thijses/longboard_2024/extra docs/mathcad file contents.png

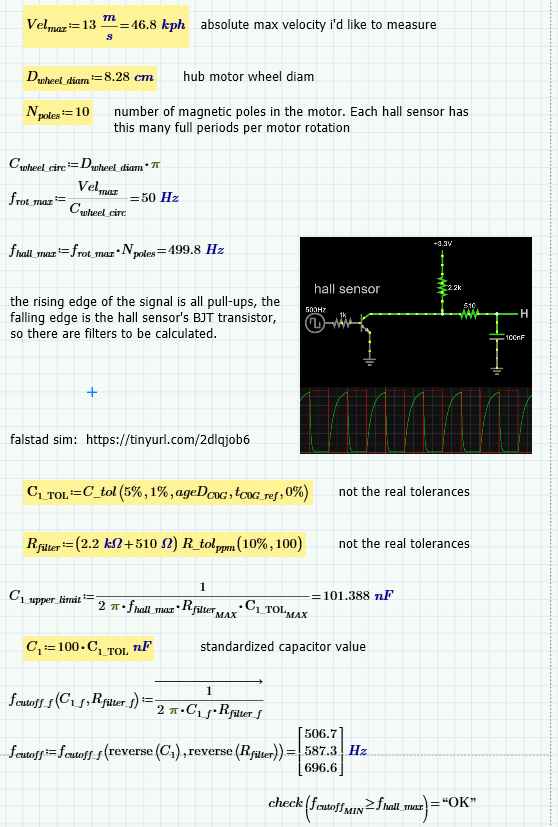
extra docs/mathcad file contents.png
