thijses/longboard_2024/extra docs/pogo board legend.png

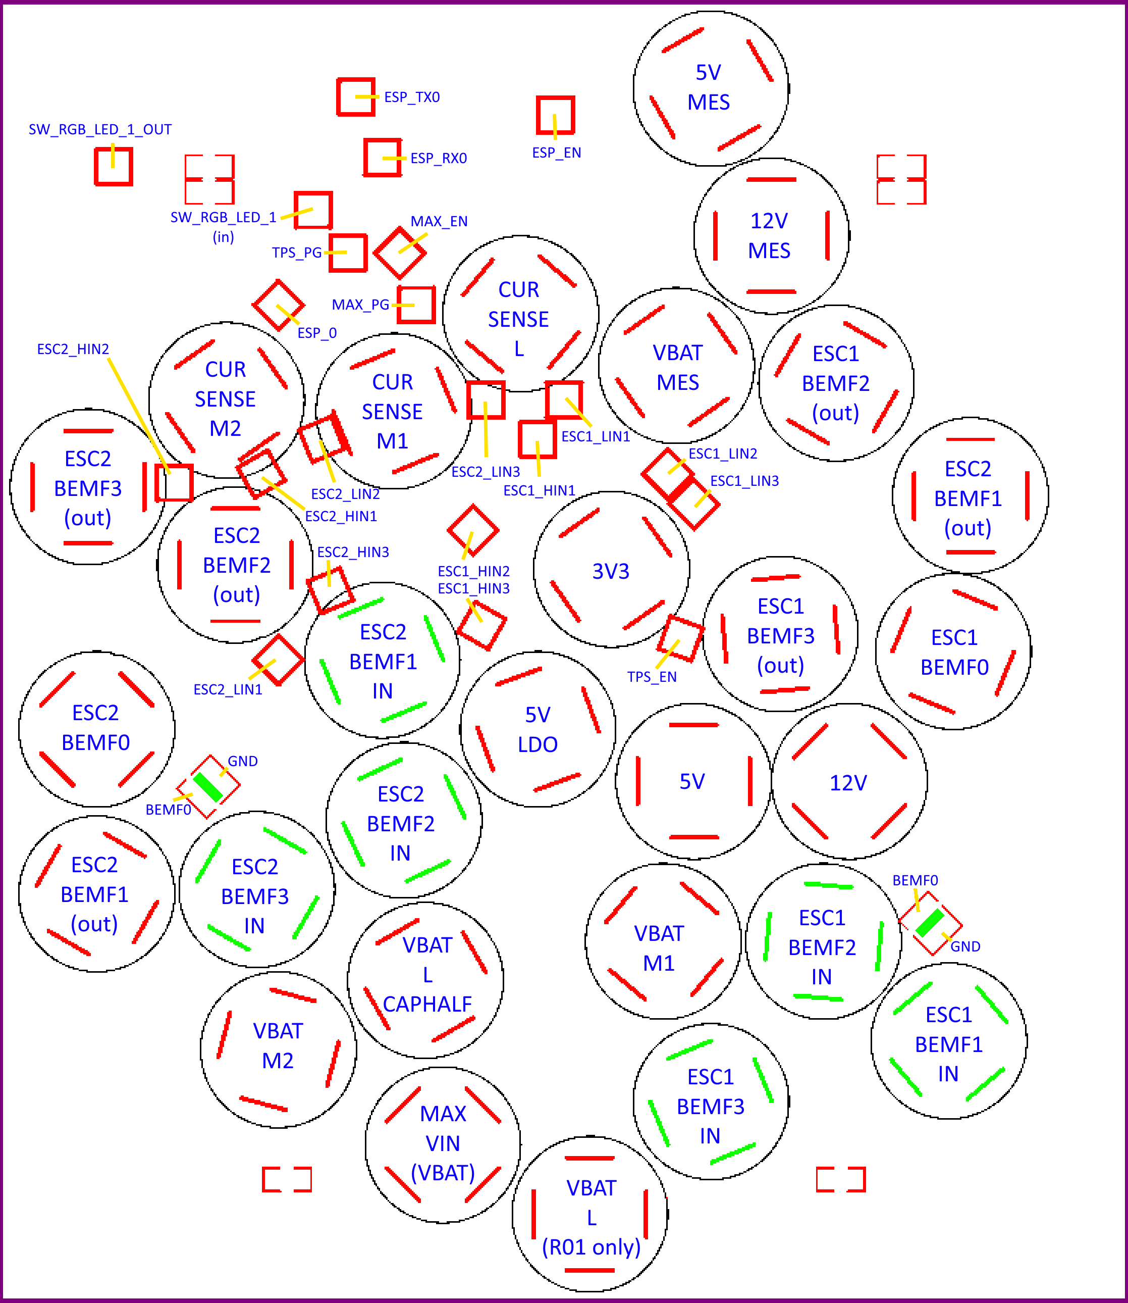
extra docs/pogo board legend.png
