thijses/longboard_2024/extra docs/scope screenshots/extra noise (unidentified).png

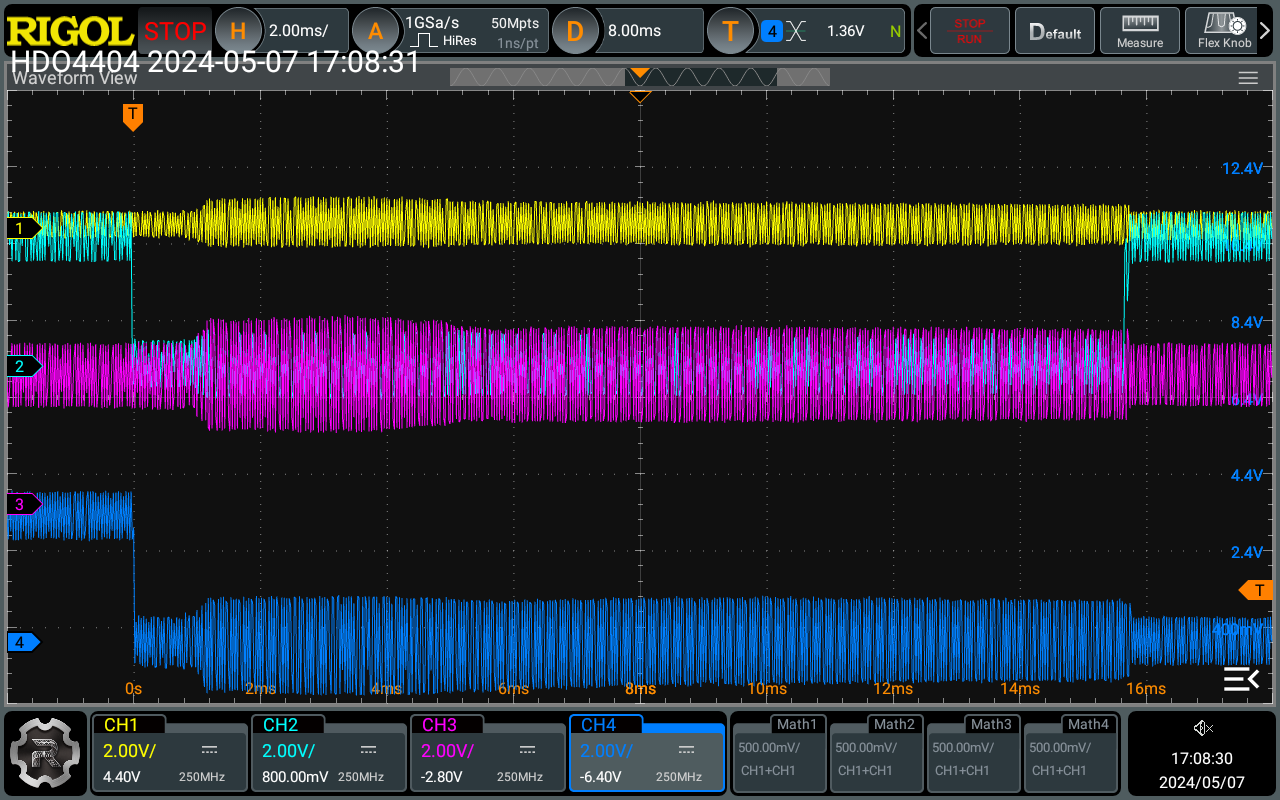
extra docs/scope screenshots/extra noise (unidentified).png
