thijses/longboard_2024/extra docs/scope screenshots/missed B (ch2) 4ms earlier, error comes on next interrupt.png

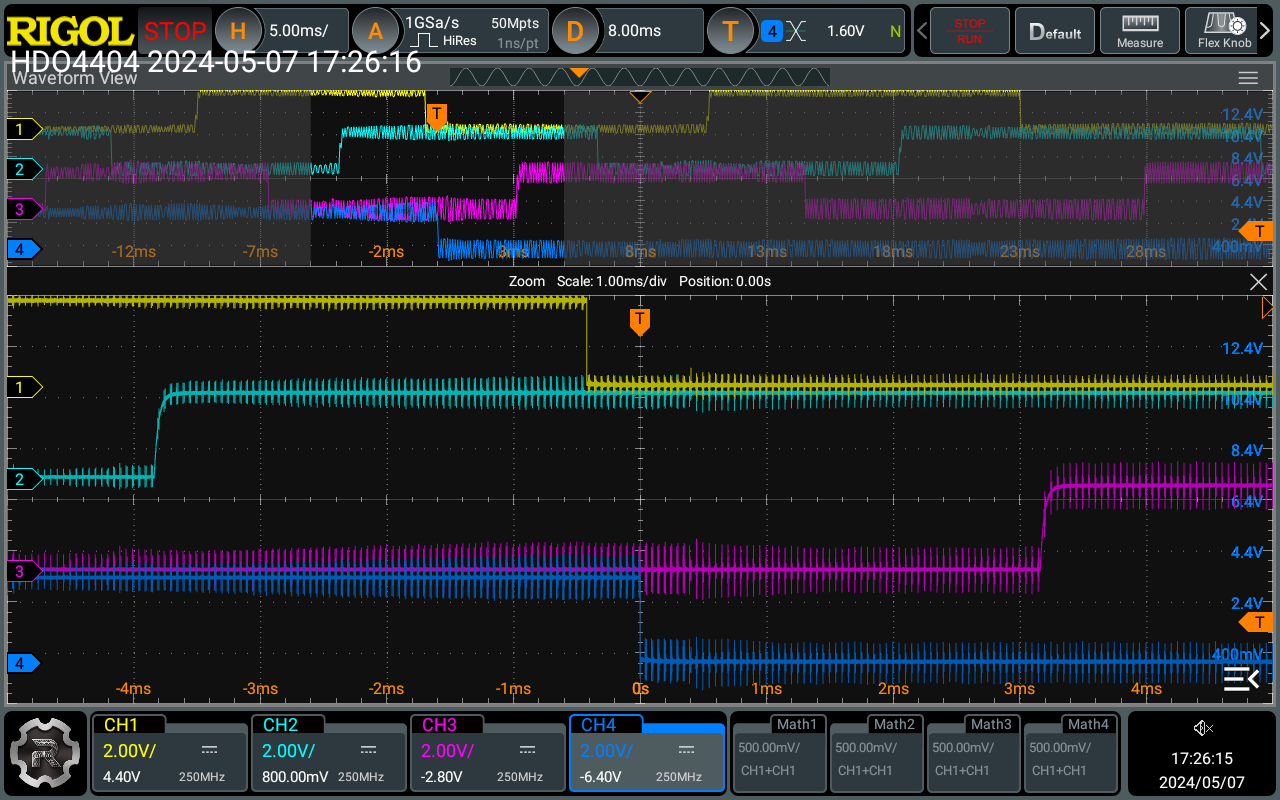
extra docs/scope screenshots/missed B (ch2) 4ms earlier, error comes on next interrupt.png
