thijses/longboard_2024/extra docs/scope screenshots/Rigol scope/3V3 @ LDO.png

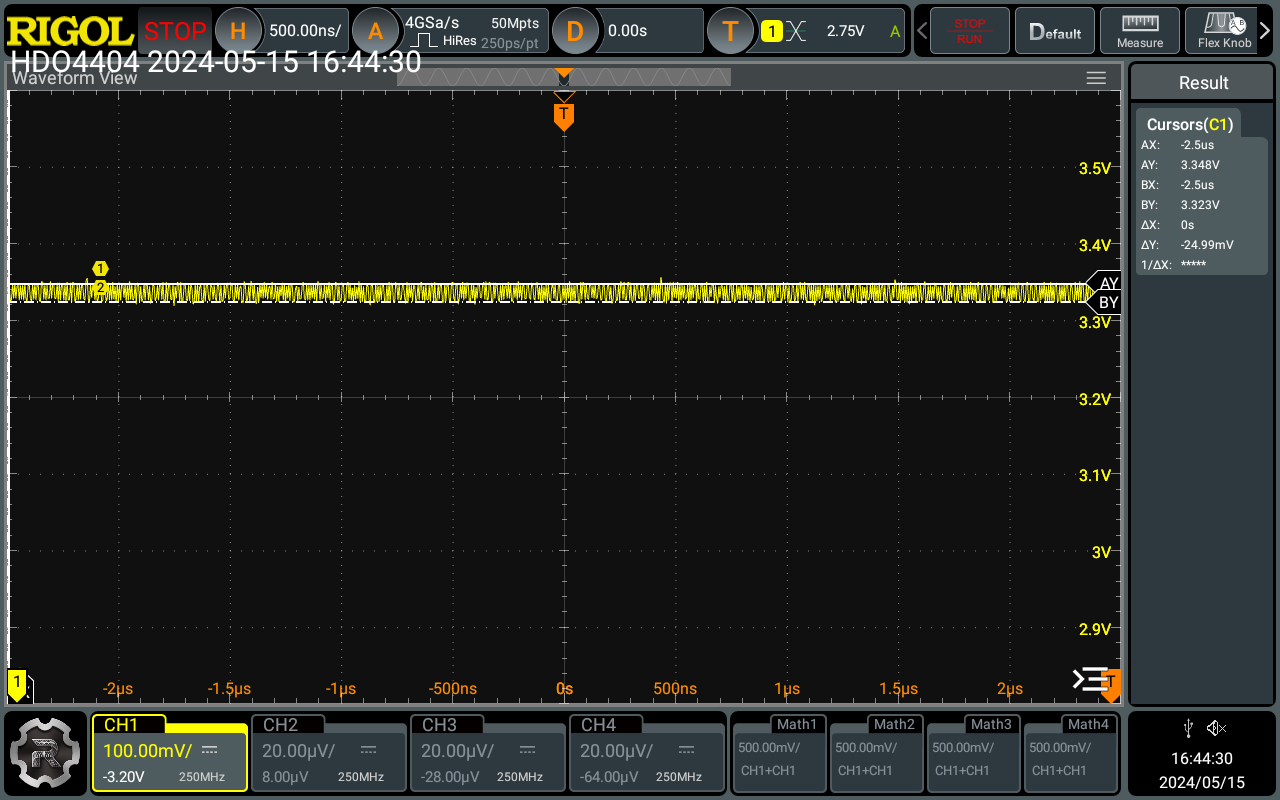
extra docs/scope screenshots/Rigol scope/3V3 @ LDO.png
