thijses/longboard_2024/extra docs/scope screenshots/Rigol scope/3V3 noise 3.png

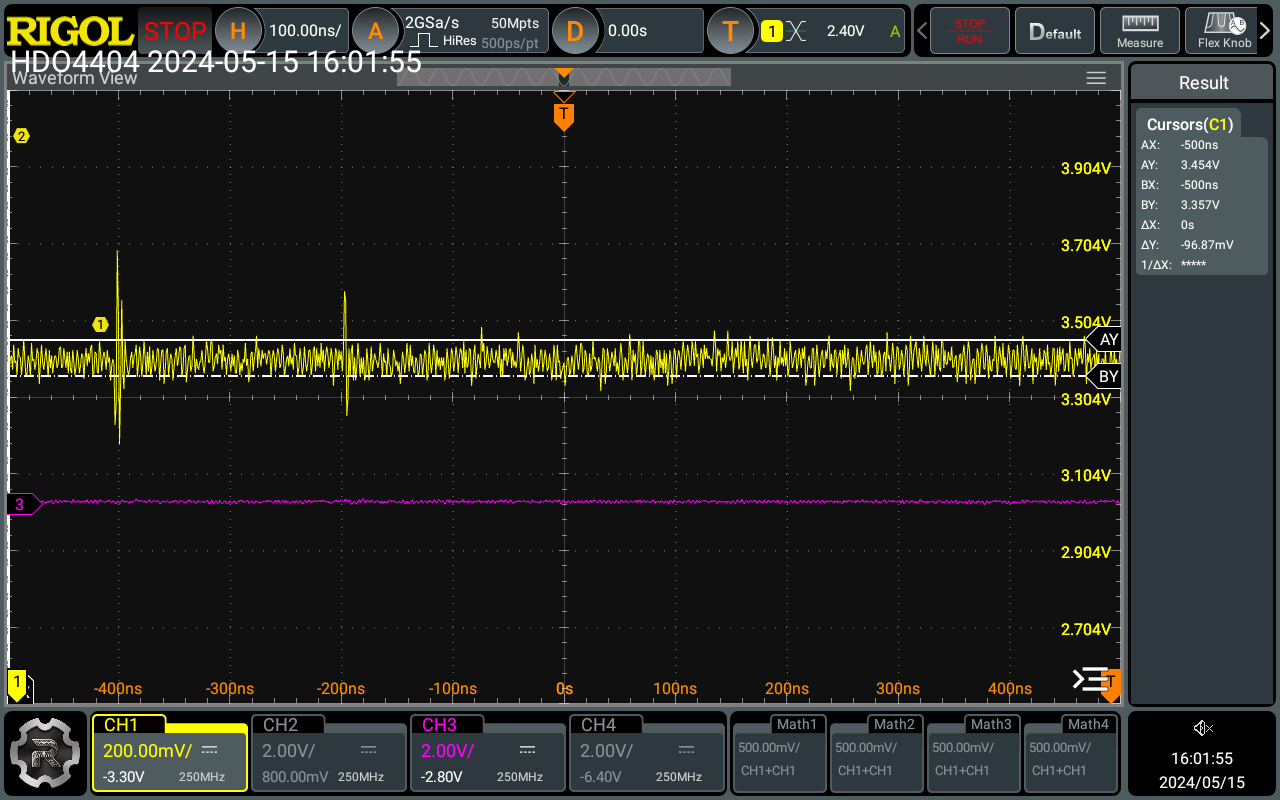
extra docs/scope screenshots/Rigol scope/3V3 noise 3.png
