thijses/longboard_2024/extra docs/scope screenshots/Rigol scope/5V @ LDO.png

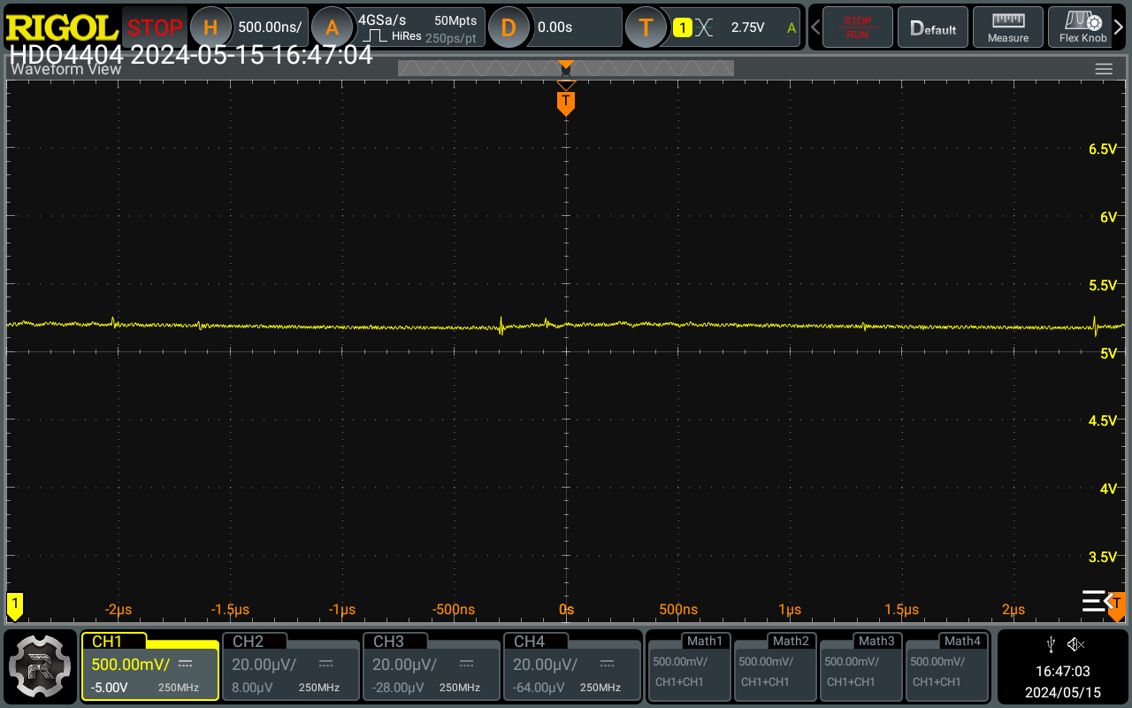
extra docs/scope screenshots/Rigol scope/5V @ LDO.png
