thijses/longboard_2024/extra docs/scope screenshots/Rigol scope/12V @ cap.png

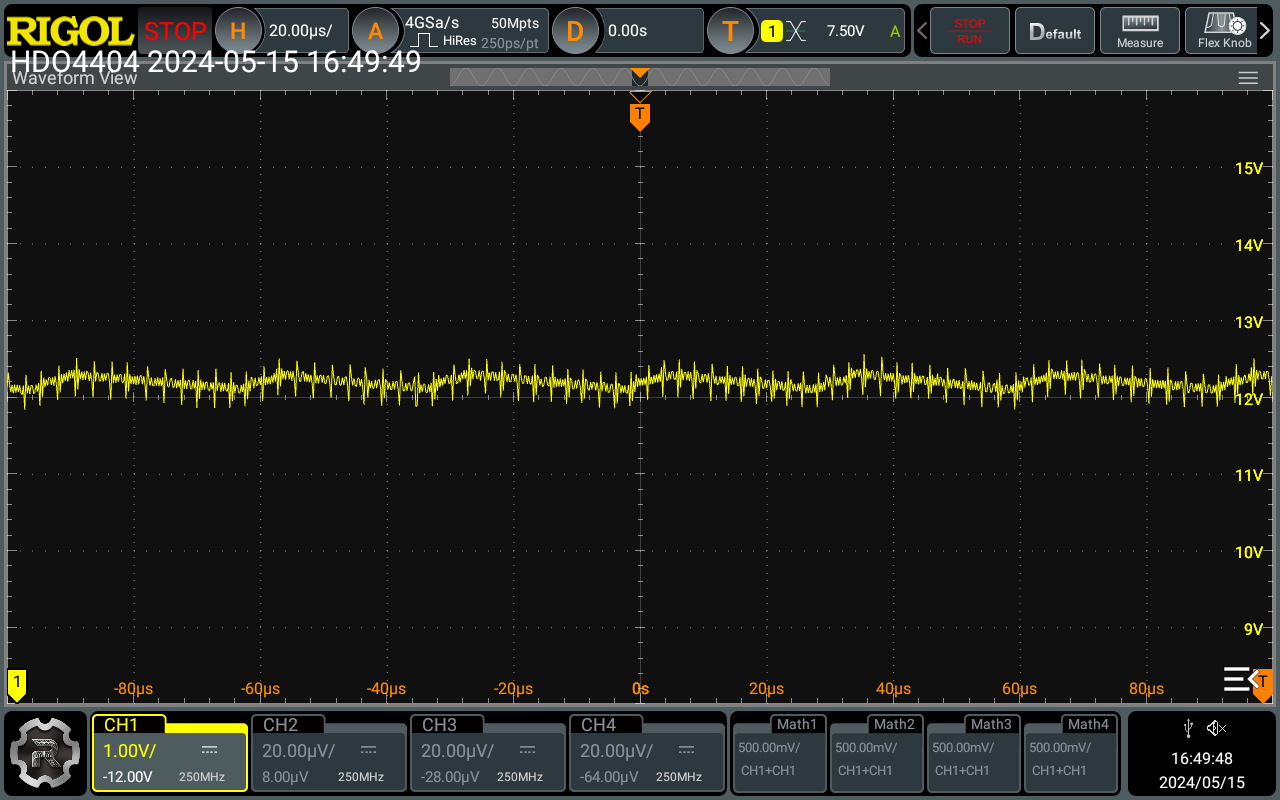
extra docs/scope screenshots/Rigol scope/12V @ cap.png
