thijses/longboard_2024/extra docs/scope screenshots/Rigol scope/no 20kHz anymore.png

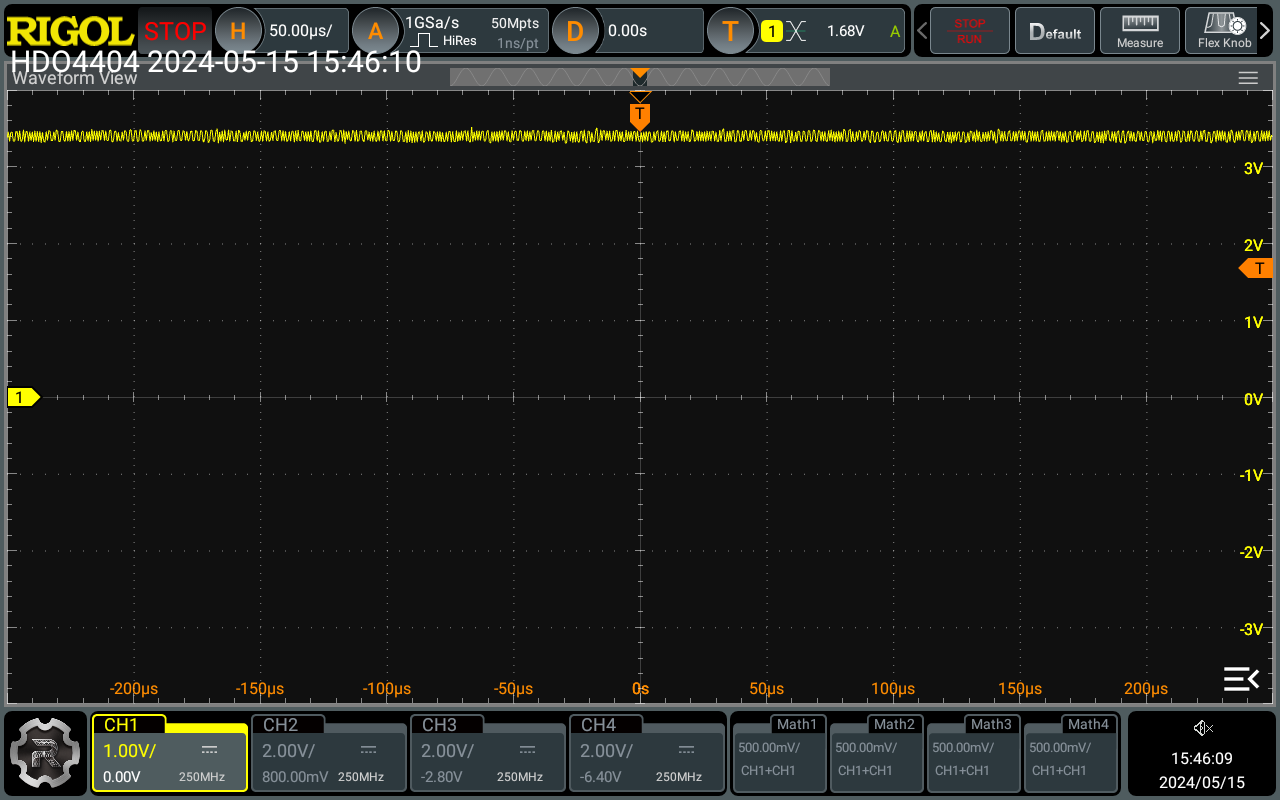
extra docs/scope screenshots/Rigol scope/no 20kHz anymore.png
