thijses/longboard_2024/extra docs/scope screenshots/showing 20kHz noise (with cursor).png

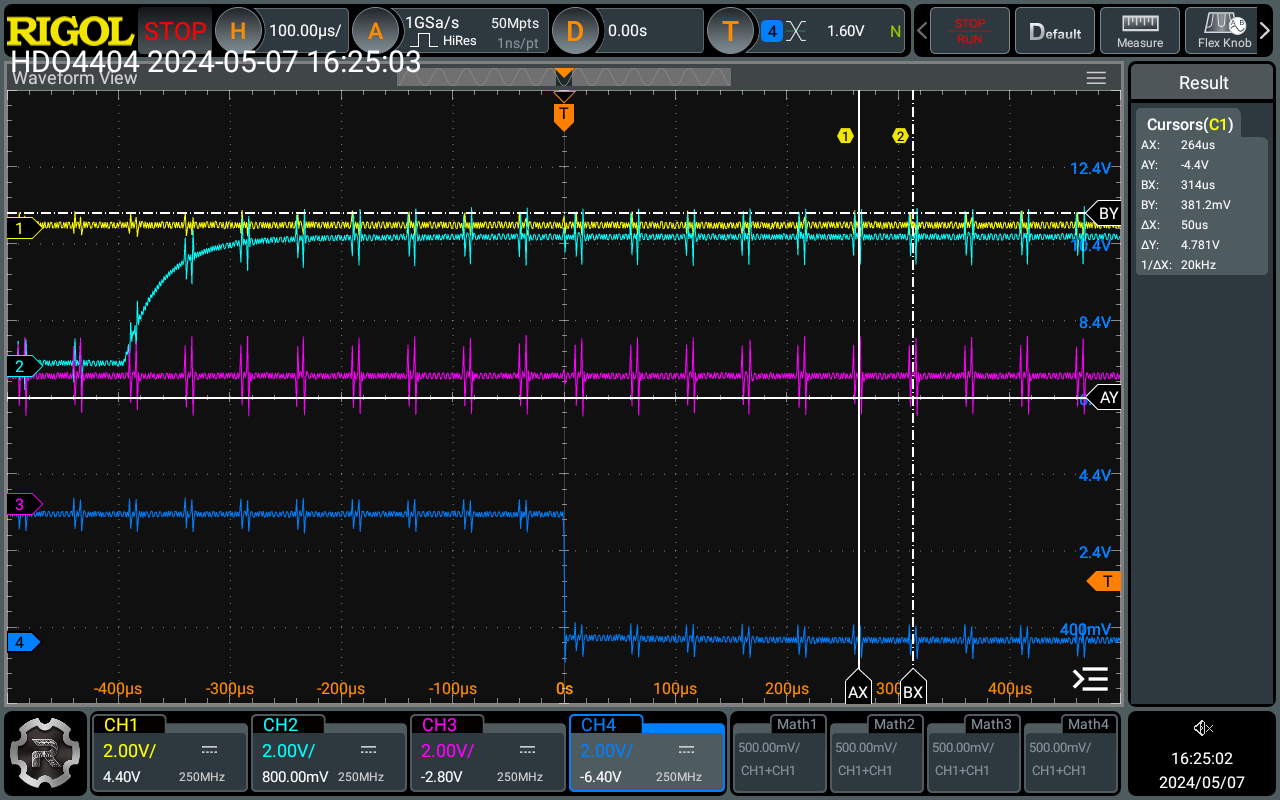
extra docs/scope screenshots/showing 20kHz noise (with cursor).png
