thijses/longboard_2024/extra docs/scope screenshots/pogo pin tests/all supplies when powered from 5S LiPo (Pk-Pk).png

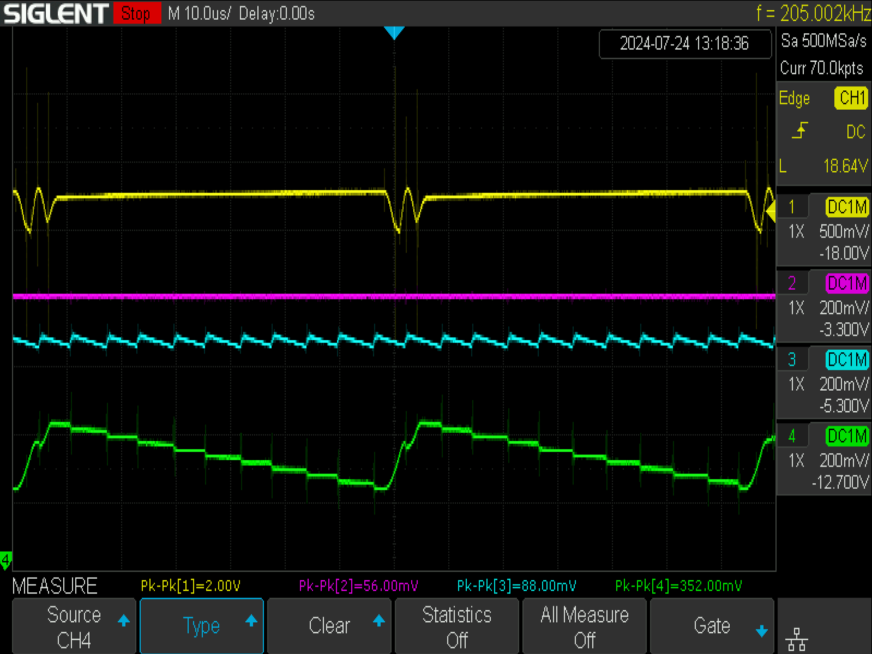
extra docs/scope screenshots/pogo pin tests/all supplies when powered from 5S LiPo (Pk-Pk).png
