thijses/longboard_2024/extra docs/scope screenshots/pogo pin tests/all supplies when powered from 16V PSU (long cable).png

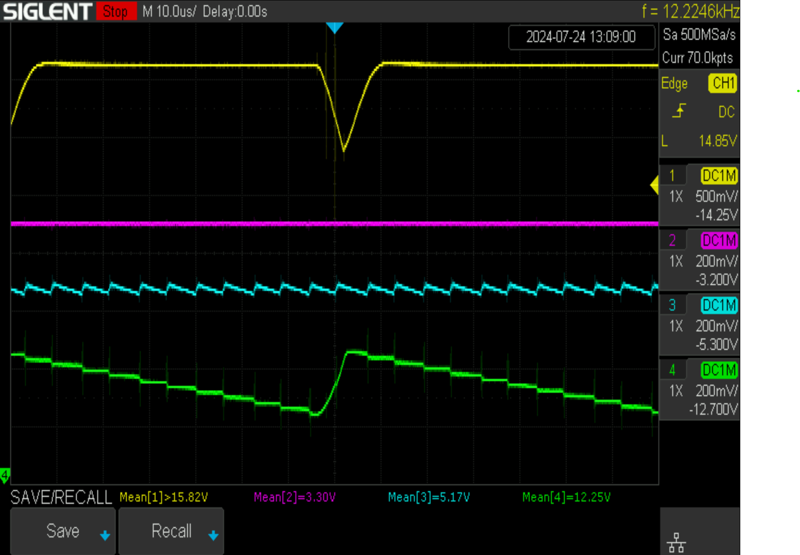
extra docs/scope screenshots/pogo pin tests/all supplies when powered from 16V PSU (long cable).png
