thijses/longboard_2024/extra docs/JTAG driver fixes/device manager after fix.png

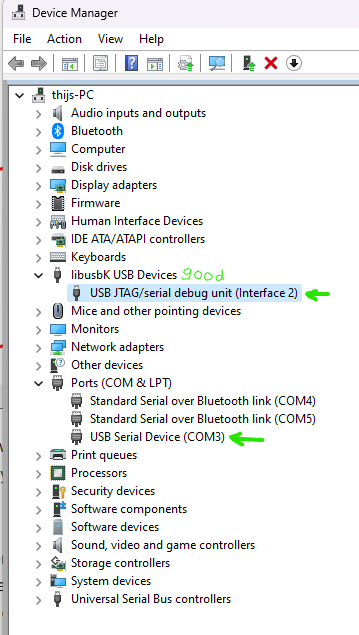
extra docs/JTAG driver fixes/device manager after fix.png
