thijses/longboard_2024/extra docs/JTAG driver fixes/zadig screenshot.png

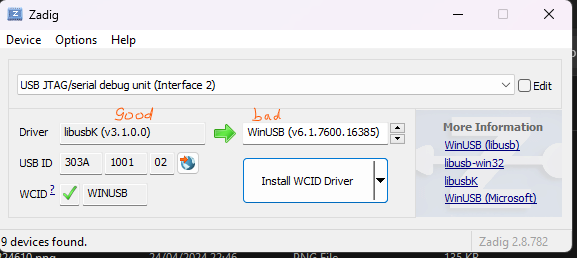
extra docs/JTAG driver fixes/zadig screenshot.png
