thijses/longboard_2024/extra docs/scope screenshots/before fixes (with filters).png

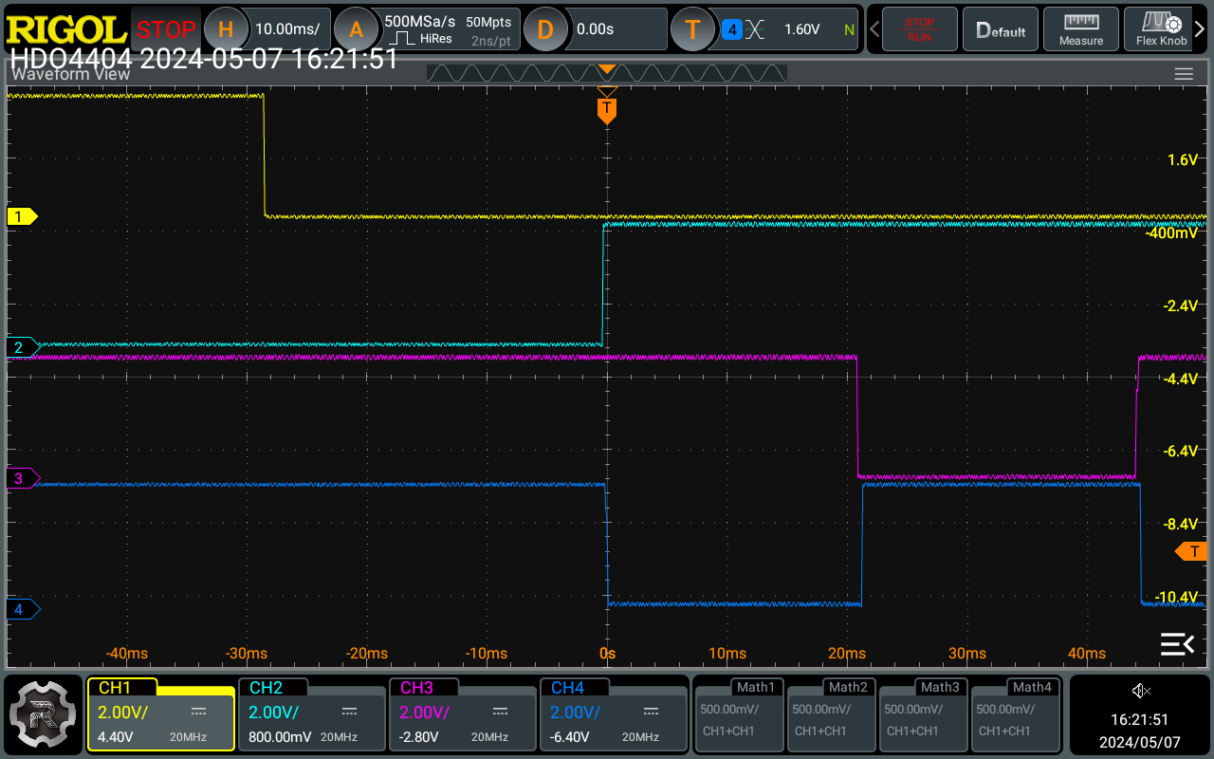
extra docs/scope screenshots/before fixes (with filters).png
