thijses/longboard_2024/src/main.cpp

/*


R02 changes:
- add low-side sense config
  * HALL_2A and ISNS_2C should be patched. Make a note in the code as well
- remove all BEMF code (because it was unfinished anyway)
- update UVLO related code/comments/debug-prints?
- (does 12V->5V diode change anything?)


TODO:
- disable MAX_SPEED_TEST
- merge SimpleFOC commits into my branch, or something like that
  * first, recall what it was i changed, (and if it's worth keeping)
    ~ i know i skip a floating point calculation, because the value was unused
    ~ i added some exception handling for HALL sensor interrupts! (this was some decent code, i'd like to keep it)
    ~ 
  * then fetch the changes from the main repo and work them into mine(?)
  * profit: https://github.com/thijses/Arduino-FOC/commit/538e59d1c93b4c41561f2d40025f36322d382104
- logging, see note below, i actually think i've got a pretty good pitch
- move LPF_velocity setting to define
- rewrite defines and motor1/motor2 stuff to reduce the number of doubled code (copy-pasting is bad)
  * also define FOC_1_USE_HALL in the motor defines by default, but with an optional AS5600/BEMF override
- write little LED_STATE struct, to make sure error states can only get worse, untill an explicit clear_error function is called
- doubled voltage_limit FOC class members? check which one is leading
- motor tuning (in depth)
  * is voltage_bemf param relevant?
- (not really my problem) i think the simpleFOC PP check is perhaps forgetting to account for imperfect hall sensor sampling.
  ~ during calibration, with PP set to 10, the check returned 12, and with PP set to 12, the check returned 14.4 (1.2x trend)
    i looked at the code at lines 253 of BLDCMotor.cpp, and concluded that the 'moved' position-delta was exactly 1 _HALL_STEPSIZE off each time.
    similarly, the arbetrary 0.5f threshold is failed, because PP * _HALL_STEPSIZE =~ 1.05, which is always > 0.5f.
    If the library simply calculates _HALL_STEPSIZE (using only known params, as i have), it could use that instead of 0.5f, to get a more logical threshold.
  ~ maybe i should contribute to the simpleFOC project with an issue report, or just a fixed branch

for release:
- (logging???)
  * note: maybe use __FILE__ and __LINE__ for easy integer error codes? (precompiler)
    ~ how about a nasty little class that encodes any error as a variable-size struct, with a __FILE__,__LINE__,Nargs,{args},(endmarker/CRC?)
      the variable-size allows freedom for logging, but means you should PROBABLY also store a logging 'head' location and counter.
      How about a functional FIFO, by just using a constant-size section of flash, and writing to a head with rollover (note: rollover should happen BEFORE writing!)
      If you also keep track of the 'tail' (the last non-overwritten entry) location (by seeing if the head has passed it),
      then you could even keep a count of how many valid datapoints currently exist, and when reading them, you'll know where to start (incl. chronologically).
      This 'head', 'tail' and counter stuff should be stored in a known section of flash (probably at the end, or something unlikely to get overwritten with code).
- find debug prints and disable (for speed)
- check_M_cur_bounds realistic

notes:
- some notes on recent hall sensor code fixes: https://github.com/simplefoc/Arduino-FOC/issues/270
- motor2 does 17km/h in the negative direction (at 22V no-load), but only 16 in the positive direction. There could be some tuning there
  * using SpaceVectorPWM it got up to +23, -26, but with lots of hall interrupt errors
  * Trapezoid_150 is a HUGE NONO! shit sounds awful
- anecdotal tests:
  * in my living room, with a 5S battery (20V), i saw it draw a cool 40Amps (40A*20V=800W=400W per motor, exactly as expected from the HUB83MM)
    ~ this also means that a 40A fuse on the 6S batteries is right on the limit already.
      with a 12S setup, if the fuse blows at high speed, i'll be thrown off my board (at high speed)
    ~ note: this did require a 100% throttle from 0 speed, with all safeguards and SW limiters turned OFF, so i can probably account for this in SW

encoder issues debugging:
- only motor1 is regularly having issues, with both 'no state change' and 'bad state -> 000'
  * ONLY when the motor is active (so it's likely motor noise)
  * mostly on B and C pins? (or A and B pins)
- motor2 had an issue once, also with 

*/

// #define MAX_SPEED_TEST // increases most safety (software) limits, ONLY FOR SHORT TEST

#include <Arduino.h>
#include "TLB_logging.h"
#include <SimpleFOC.h>
#include "driver/temp_sensor.h"


#define _KPH_TO_MPS     (0.27777777778f) // 1/3.6
#define _MPS_TO_KPH     (3.60000000000f) // 3.6
#define _RADPS_TO_ROTPS (0.15915494309f) // 1/TWO_PI

#ifdef MAX_SPEED_TEST
  const float speedLimit = _KPH_TO_MPS*35.0; // (meters/sec) ONLY FOR SHORT TEST!
#else
  const float speedLimit = _KPH_TO_MPS*25.0; // (meters/sec) speed limit of longboard
#endif
const float CPU_temperature_limit = 85.0f; // (deg Celsius) software temperature limit (starts ESCs free-wheeling)
const uint32_t radioSilenceTimeout = 2000; // (millis) if radio has been silent for this long, start free-wheeling
const bool forwardDirection = true; // a boolean used to flip forward direction. Personally, i prefer front-wheel drive, and i recently flipped the ESC around.

const bool FOC_core = ARDUINO_RUNNING_CORE; // which core to run FOC stuff on (see also: ARDUINO_RUNNING_CORE and ARDUINO_EVENT_RUNNING_CORE)

#if ARDUINO_USB_CDC_ON_BOOT
  #define debugSerial  Serial // use ESP32-S3's native USB JTAG+serial for debug output
  //#define HWserial0 Serial0
#else
  #define debugSerial  USBSerial // use ESP32-S3's native USB JTAG+serial for debug output
  //#define HWserial Serial
#endif
// #if SOC_UART_NUM > 1
//   #define HWserial1 Serial1
// #endif
// #if SOC_UART_NUM > 2
//   #define HWserial2 Serial2
// #endif

#define RELEASE_BUILD_CHECK  (CORE_DEBUG_LEVEL > 0) // if building in release mode, speed and reliability are more important than debug data no-one will/can read

#include "TLB_pinouts.h" // defines pins (based on PCB_R0x)
#include "TLB_ESCs.h" // ESC stuff got too long, so i put it in a header file
#include "TLB_comm.h"

#ifdef MOTOR1_WHEELCIRCUM // only for motor1, because i'm lazy
  #define _RADPS_TO_KPH (_RADPS_TO_ROTPS * MOTOR1_WHEELCIRCUM * _MPS_TO_KPH)
  #define _KPH_TO_RADPS (1.0f/_RADPS_TO_KPH)
#endif

//// TODO: abstract ESC1 away for these constants
const float maxForwardTorqueScalar = 1.0;
const float maxBrakingTorqueScalar = 0.75; // strong braking (to be softened by reducing it as speed reduces)
const float brakingDecreaseThresh = 5.0f * _KPH_TO_RADPS; // (radians/sec) once speed drops below this (final number in radians/sec), reduce braking
const float _brakingDecreaseThreshInverted = 1.0f/brakingDecreaseThresh; // efficiency trick
//// TODO: bell-curve (sinusoidal/hyperbolic) braking (weak when going fast, weak when standing still, strong in the middle)

///////////////////////////////////////// ADC constants /////////////////////////////////////////
const float check_3V3_bounds[2] = {3.2, 3.4}; // (Volt) 3V3 measurements should fall within these bounds
const float check_5V_bounds[2] = {4.9, 5.3}; // (Volt) 5V measurements should fall within these bounds
const float check_12V_bounds[2] = {11.8, 12.3}; // (Volt) 12V measurements should fall within these bounds (for happy operation. If it exits this range, maybe slow down (gently))
const float check_12V_bounds_ext[2] = {9.6, 12.3}; // (Volt) 12V measurements MUST fall within these bounds (for minimum operation)
const float check_VBAT_bounds[2] = {13.5, 54.6}; // (Volt) VBAT measurements should fall within these bounds (for happy operation. If it exits this range, maybe slow down (gently))
const float check_VBAT_bounds_ext[2] = {9.7, 60.0}; // (Volt) VBAT measurements MUST fall within these bounds (for minimum operation. Note: UVLO will kick in)
const float check_L_cur_bounds[2] = {-0.25, 1.0}; // (Amps) VBAT_L current measurements should fall within these bounds (for happy operation)
const float check_L_cur_bounds_ext[2] = {-0.5, 5.0}; // (Amps) VBAT_L current measurements MUST fall within these bounds (otherwise something is on fire)
const float check_M_cur_bounds[2] = {-0.5, ESC1_CURRENT_LIMIT}; // (Amps) VBAT_M# current measurements should fall within these bounds (for happy operation)
const float check_M_cur_bounds_ext[2] = {-2.0, ESC_CURRENT_SENSOR_MAX}; // (Amps) VBAT_M# current measurements MUST fall within these bounds (otherwise something is on fire)
// #if defined(ESC1_CURRENT_LIMIT) && defined(ESC2_CURRENT_LIMIT) && (ESC1_CURRENT_LIMIT != ESC1_CURRENT_LIMIT) // seperate current limits for each motor?
//   const float check_M2_cur_bounds[2] = {-5.0, 5.0}; // (Amps) VBAT_M# current measurements should fall within these bounds (for happy operation)
//   const float check_M2_cur_bounds_ext[2] = {-25.0, 25.0}; // (Amps) VBAT_M# current measurements MUST fall within these bounds (otherwise something is on fire)
// #endif

#include "TLB_analog.h" // ADC stuff got too long, so i put it in a header file

float VBAT_used_for_FOC = -1.0;
int8_t cellCount; // gets initialized in setup()
// const uint8_t minimumCellCount = ceil(check_VBAT_bounds_ext[0] / _lithiumCellThresholds[0]); // battery can NEVER drop below absolute minimum cell voltage
const uint8_t minimumCellCount = floor(check_VBAT_bounds_ext[0] / _lithiumCellThresholds[1]); // fuck it, let the user decide when to fall off their board
float dynamic_VBAT_bounds[4] = {-1.0}; // (Volt) VBAT bounds set on boot, based on estimated battery cell count and _lithiumCellThresholds[]
bool batteryWarningDone = false; // to avoid spam, only send/log/announce a battery warning once (untill reset)
bool batteryErrorDone = false; // once the battery drops to dangerous voltages, stop all powered-control (and start free-wheeling). Also only log once

float CPU_temperature = 20.0;
const float temperature_good_hyst = 5.0; // after an over-temperature event, the temperature needs to drop at least this much to be considered 'good' again
volatile bool CPU_temperature_good=true;

#ifdef DELAY_FREEWHEEL_UNTILL_SPEED_LOW
  bool delayedFreewheel=false; // (single-core) set to true instead of freewheelMultiCore
  const float startFreewheelMaxSpeed = 3.0f * _KPH_TO_RADPS; // (radians/sec) speed threshold at which freewheeling can safely start
  #ifdef DELAY_FREEWHEEL_SMOOTHLY // if this is defined, 
    //// TODO: delay constants & timer variable
    const float delayFreewheelThrotle = 0.0f; // (-1.0 to 1.0) throttle value (absolute(?)) to apply instead of freewheeling. Setting this low still causes a shock
  #else
    //// NOTE: Without DELAY_FREEWHEEL_SMOOTHLY a throttle value of 0 may still cause some shock
    const float delayFreewheelThrotle = 0.0f; // (-1.0 to 1.0) throttle value (absolute(?)) to apply instead of freewheeling.
  #endif
#endif

uint32_t loopStartTime; // (millis) record when setup() finished and loop() started

const float LPF_cur_Tf = 0.1; // Low-Pass Filter time constant for current sensors
LowPassFilter LPF_cur_L_debug{LPF_cur_Tf}; // TODO: relpace with efficient FIFO or some shit?
LowPassFilter LPF_cur_M1_debug{LPF_cur_Tf}; // TODO: relpace with efficient FIFO or some shit?
LowPassFilter LPF_cur_M2_debug{LPF_cur_Tf}; // TODO: relpace with efficient FIFO or some shit?
const float LPF_VBAT_Tf = 0.5; // Low-Pass Filter time constant for current sensors
LowPassFilter LPF_VBAT_debug{LPF_VBAT_Tf}; // TODO: relpace with efficient FIFO or some shit?
// const float LPF_speed_Tf = 0.05; // Low-Pass Filter time constant for current sensors
// LowPassFilter LPF_speed_debug{LPF_speed_Tf}; // deleteme

const uint32_t batteryCheckStartTime = (LPF_VBAT_Tf * 1000.0) * 2; // only start checking battery voltage after this amount of time has passed (after loopStartTime!)

uint32_t debugPrintTimer;
const uint32_t debugPrintInterval = 500; // (millis)

///////////////////////////////////////// RGB LED colors ////////////////////////////////////////
//// these defines are used in neopixelWrite(pin,r,g,b) like (pin,defined), where 'defined' contains the last 2 commas
#define RGB_LED_OFF         0,  0,  0 // off
#define RGB_LED_OK          0, 64,  0 // green
#define RGB_LED_WARNING    55, 20,  0 // orange
#define RGB_LED_ERROR      64,  0,  0 // red
#define RGB_LED_INFO_1      0,  0, 64 // blue    (so far, this one is unused, making it perfect for debug stuff)
#define RGB_LED_INFO_2     64,  0, 64 // purple  (used for radio issues)
#define RGB_LED_INFO_3     64, 64, 64 // white   (used at boot (before ANYTHING else))



bool initPSUs() {
  //// first, enable pins
  #ifdef PIN_MAX_EN_HIGH_Z
    //// TODO: open-source vs open-drain based on value of PIN_MAX_EN_HIGH_Z
    pinMode(PIN_MAX_EN, OUTPUT_OPEN_DRAIN);
  #else
    pinMode(PIN_MAX_EN, OUTPUT);
  #endif
  digitalWrite(PIN_MAX_EN, PIN_MAX_EN_ACTIVE); // make sure the device is enabled
  #ifdef PIN_TPS_EN_HIGH_Z
    //// TODO: open-source vs open-drain based on value of PIN_TPS_EN_HIGH_Z
    pinMode(PIN_TPS_EN, OUTPUT_OPEN_DRAIN);
  #else
    pinMode(PIN_TPS_EN, OUTPUT);
  #endif
  digitalWrite(PIN_TPS_EN, PIN_TPS_EN_ACTIVE); // make sure the device is enabled
  //// next, power-good pins
  pinMode(PIN_MAX_PG, INPUT);
  pinMode(PIN_TPS_PG, INPUT);
  delay(10); // idk, why not
  if(digitalRead(PIN_MAX_PG) != PIN_MAX_PG_ACTIVE) { TLB_log_w("MAX (12V) Power-Good is not ACTIVE!?"); }
  if(digitalRead(PIN_TPS_PG) != PIN_TPS_PG_ACTIVE) { TLB_log_w("TPS (5V) Power-Good is not ACTIVE!?"); }
  return(true); // TODO: return something helpful
}

bool initADCpins() {
  pinMode(PIN_5V_MES, ANALOG); // simple voltage divider to measure 5V supply
  pinMode(PIN_12V_MES, ANALOG); // simple voltage divider to measure 12V supply
  pinMode(PIN_VBAT_MES, ANALOG); // simple voltage divider to measure VBAT
  pinMode(PIN_CUR_SENSE_L, ANALOG); // 10A current sensor for everything but the motors (e.g. power supplies). Measured at VBAT high-side
  pinMode(PIN_CUR_SENSE_M1, ANALOG); // 30A current sensor for motor 1. Measured at VBAT high-side
  pinMode(PIN_CUR_SENSE_M2, ANALOG); // 30A current sensor for motor 2. Measured at VBAT high-side
  float testVal; // give everything a quick test, just make sure nothing is immediately on fire
  testVal=mes_3V3(); if((testVal<check_3V3_bounds[0])||(testVal>check_3V3_bounds[1])) {TLB_log_w("3V3 out of bounds! %.2fV", testVal); neopixelWrite(RGB_BUILTIN, RGB_LED_WARNING);}
  testVal=mes_5V(); if((testVal<check_5V_bounds[0])||(testVal>check_5V_bounds[1])) {TLB_log_w("5V out of bounds! %.2fV", testVal); neopixelWrite(RGB_BUILTIN, RGB_LED_WARNING);}
  testVal=mes_12V(); if((testVal<check_12V_bounds[0])||(testVal>check_12V_bounds[1])) {TLB_log_w("12V out of bounds! %.2fV", testVal); neopixelWrite(RGB_BUILTIN, RGB_LED_WARNING);}
  else if((testVal<check_12V_bounds_ext[0])||(testVal>check_12V_bounds_ext[1])) {TLB_log_w("12V out of EXTENDED bounds! %.2fV", testVal); neopixelWrite(RGB_BUILTIN, RGB_LED_ERROR);}
  testVal=mes_VBAT(); if((testVal<check_VBAT_bounds[0])||(testVal>check_VBAT_bounds[1])) {TLB_log_w("VBAT out of bounds! %.2fV", testVal); neopixelWrite(RGB_BUILTIN, RGB_LED_WARNING);}
  else if((testVal<check_VBAT_bounds_ext[0])||(testVal>check_VBAT_bounds_ext[1])) {TLB_log_w("VBAT out of EXTENDED bounds! %.2fV", testVal); neopixelWrite(RGB_BUILTIN, RGB_LED_ERROR);}
  testVal=mes_Lcurrent(); if((testVal<check_L_cur_bounds[0])||(testVal>check_L_cur_bounds[1])) {TLB_log_w("VBAT_L current out of bounds! %.2fA", testVal); neopixelWrite(RGB_BUILTIN, RGB_LED_WARNING);}
  else if((testVal<check_L_cur_bounds_ext[0])||(testVal>check_L_cur_bounds_ext[1])) {TLB_log_w("VBAT_L current out of EXTENDED bounds! %.2fA", testVal); neopixelWrite(RGB_BUILTIN, RGB_LED_ERROR);}
  testVal=mes_M1current(); if((testVal<check_M_cur_bounds[0])||(testVal>check_M_cur_bounds[1])) {TLB_log_w("Motor 1 current out of bounds! %.1fA", testVal); neopixelWrite(RGB_BUILTIN, RGB_LED_WARNING);}
  else if((testVal<check_M_cur_bounds_ext[0])||(testVal>check_M_cur_bounds_ext[1])) {TLB_log_w("Motor 1 current out of EXTENDED bounds! %.1fA", testVal); neopixelWrite(RGB_BUILTIN, RGB_LED_ERROR);}
  testVal=mes_M2current(); if((testVal<check_M_cur_bounds[0])||(testVal>check_M_cur_bounds[1])) {TLB_log_w("Motor 2 current out of bounds! %.1fA", testVal); neopixelWrite(RGB_BUILTIN, RGB_LED_WARNING);}
  else if((testVal<check_M_cur_bounds_ext[0])||(testVal>check_M_cur_bounds_ext[1])) {TLB_log_w("Motor 2 current out of EXTENDED bounds! %.1fA", testVal); neopixelWrite(RGB_BUILTIN, RGB_LED_ERROR);}
  return(true); // TOOD: return something helpful
}

bool initEXT_PERIPHpins() { // these pins can also be used for debugging
  pinMode(PIN_EXT_PERIPH_1, OUTPUT); /*digitalWrite(PIN_EXT_PERIPH_1, LOW);*/
  pinMode(PIN_EXT_PERIPH_2, OUTPUT); /*digitalWrite(PIN_EXT_PERIPH_1, LOW);*/
  return(true);
}

bool initRGB_LED(uint8_t red_val=0, uint8_t green_val=0, uint8_t blue_val=0) {
  pinMode(LED_BUILTIN, OUTPUT); /*digitalWrite(LED_BUILTIN, LOW);*/
  neopixelWrite(RGB_BUILTIN, red_val,green_val,blue_val); // set a state (because the LED will maintain its status between resets)
  delayMicroseconds(400); // latch the data
  return(true); // TOOD: return something helpful
}

void initTempSensor(){
  temp_sensor_config_t temp_sensor = TSENS_CONFIG_DEFAULT();
  temp_sensor.dac_offset = TSENS_DAC_L2;  // TSENS_DAC_L2 is default; L4(-40°C ~ 20°C), L2(-10°C ~ 80°C), L1(20°C ~ 100°C), L0(50°C ~ 125°C)
  temp_sensor_set_config(temp_sensor);
  temp_sensor_start();
}

void errorHaltHandler() {
  if(debugSerial) { while(debugSerial.available()) { debugSerial.read(); } } // flush serial buffer
  while(1) {
    delay(1000);neopixelWrite(RGB_BUILTIN, RGB_LED_OFF);delay(1000);neopixelWrite(RGB_BUILTIN, RGB_LED_ERROR);
    TLB_log_i("stopped");
    if(debugSerial) { while(debugSerial.available()) { char readChar=debugSerial.read(); if((readChar=='r')||(readChar=='r')){ ESP.restart(); } } }
  }
}

/////////////////////////////////////////// multi-core /////////////////////////////////////////
volatile float currentSpeedMultiCore; // (radians/sec) current speed is passed between cores (from FOC core to other core)
volatile float newTargetUnscaledMultiCore; // (-1.0 to 1.0) updated motor target is passed between cores (from other core to FOC core)
volatile bool newTargetUnscaledMultiCore_flag=false; // very minor optimization, to avoid checking/using newTargetUnscaledMultiCore every loop
volatile bool coreFOCsetup_flag=false;
volatile bool freewheelMultiCore = false; // whether freewheeling should be enabled

const uint32_t coreFOCspeedUpdateInterval = 20; // time between currentSpeedMultiCore updates. Should match/exceed transmitter update freq
uint32_t coreFOCspeedUpdateTimer;

void coreFOCloop() { // the code that loops the core that handles the FOC stuff
  //// debug:
  // ESC1_motor.target = sin((millis()-loopStartTime) / 3000.0f) * ESC1_motor.voltage_limit; // set motor torque in 'volt' (out of max_volt)
  // ESC2_motor.target = sin((millis()-loopStartTime) / 3000.0f) * ESC2_motor.voltage_limit; // set motor torque in 'volt' (out of max_volt)
  
  //// virtual link code (from video: https://youtu.be/xTlv1rPEqv4?si=aYMAJuWkvaOria6V&t=126)
  // ESC1_motor.shaft_angle = ESC1_motor.shaftAngle();  ESC2_motor.shaft_angle = ESC2_motor.shaftAngle(); // after my optimization, this has become necessary for the code below
  // const float linkPower = 5; // how strong the 'link' should be ('voltage' torque response proportional to angle difference (in radians))
  // ESC1_motor.move( linkPower*((-ESC2_motor.shaft_angle) - ESC1_motor.shaft_angle));
  // ESC2_motor.move( linkPower*((-ESC1_motor.shaft_angle) - ESC2_motor.shaft_angle));

  //// uint32_t one = ESP.getCycleCount(); // the simpleFOCupdate (for both motors) appears to take about <100us, so that's not too terrible
  simpleFOCupdate(); // run as often as possible 
  // ESC1_sensor.update();
  //// uint32_t two = ESP.getCycleCount();

  if(ESC1_motor.enabled && freewheelMultiCore) { simpleFOCstartFreeWheel(); }
  else if((!ESC1_motor.enabled) && (!freewheelMultiCore)) { simpleFOCstopFreeWheel(); }
  
  if((millis()-coreFOCspeedUpdateTimer) >= coreFOCspeedUpdateInterval) { // pass speed value back to main core
    coreFOCspeedUpdateTimer = millis();
    #if ESC1_DEFINED && ESC2_DEFINED
      float currentSpeed = ((forwardDirection ? ESC1_motor.shaft_velocity : (-ESC1_motor.shaft_velocity))
                            +(forwardDirection ? (-ESC2_motor.shaft_velocity) : ESC2_motor.shaft_velocity) // reverse velocity
                            )*0.5f;
    #elif ESC1_DEFINED
      float currentSpeed = (forwardDirection ? ESC1_motor.shaft_velocity : (-ESC1_motor.shaft_velocity));
    #else // ESC2_DEFINED
      float currentSpeed = (forwardDirection ? (-ESC2_motor.shaft_velocity) : ESC2_motor.shaft_velocity); // reverse velocity
    #endif
    currentSpeedMultiCore = currentSpeed;
  }

  if(newTargetUnscaledMultiCore_flag) {
    float newTarget = newTargetUnscaledMultiCore; // NOTE: still (-1.0 to 1.0) scalar
    newTargetUnscaledMultiCore_flag = false; // clearing this flag after newTargetUnscaledMultiCore is used is fancy, but currently unused
    newTarget *= ESC1_motor.voltage_limit; // scale to 'voltage'
    #if ESC1_DEFINED
      ESC1_motor.target = (forwardDirection ? newTarget : (-newTarget));
    #endif
    #if ESC2_DEFINED
      ESC2_motor.target = (forwardDirection ? (-newTarget) : newTarget); // reverse input!
    #endif
  }
}

void coreFOCsetup(void* arg) { // the 'task' that is started on the second core (core 0)

  simpleFOCinit(VBAT_used_for_FOC); // init ESC pins and whatnot (multicore note: motor_status will be motor_initializing)
  if(ESC1_motor.motor_status != FOCMotorStatus::motor_uncalibrated) { // should be motor_uncalibrated, otherwise will be motor_init_failed
    TLB_log_e("FOC init (pins) failed! %x",ESC1_motor.motor_status); neopixelWrite(RGB_BUILTIN, RGB_LED_ERROR);
    errorHaltHandler();
  }
  TLB_log_v("FOC basic init done");

  //// some debug: (read back parameters (post-constraints), see MAX_SPEED_TEST)
  float velocityLimitKPH = ESC1_motor.velocity_limit * _RADPS_TO_KPH; // (only motor 1 is printed)
  TLB_log_v("velocity limit: %.2f km/h", velocityLimitKPH);
  TLB_log_v("theoretical voltage limit: %.2f V", ESC1_VOLTAGE_LIMIT); // (only motor 1 is printed)
  TLB_log_v("voltage limit (this battery): %.2f V", ESC1_motor.voltage_limit); // (only motor 1 is printed)
  TLB_log_v("current limit (per motor): %.2f A", ESC1_motor.current_limit); // (only motor 1 is printed) NOTE: currently open-loop (sensor unused)
  TLB_log_v("power limit (per motor): %.2f W", ESC1_motor.voltage_limit * ESC1_motor.current_limit); // (only motor 1 is printed)
  TLB_log_v("theoretical power limit (per motor): %.2f W", ESC1_VOLTAGE_LIMIT * ESC1_motor.current_limit); // (only motor 1 is printed)

  //// init other stuff...

  //// first, check the battery voltage
  if((VBAT_used_for_FOC<check_VBAT_bounds_ext[0])||(VBAT_used_for_FOC>check_VBAT_bounds_ext[1])) {
    TLB_log_e("not starting FOC, VBAT sucks! %.2fV", VBAT_used_for_FOC); neopixelWrite(RGB_BUILTIN, RGB_LED_ERROR);
    errorHaltHandler();
  }
  if(cellCount < minimumCellCount) {
    TLB_log_e("not starting FOC, VBAT cell count estimate sucks! %d", cellCount); neopixelWrite(RGB_BUILTIN, RGB_LED_ERROR);
    errorHaltHandler();
  }

  //// start FOC
  if((ESC_CONTROL_TYPE==MotionControlType::torque) || (ESC_CONTROL_TYPE==MotionControlType::velocity) || (ESC_CONTROL_TYPE==MotionControlType::angle)) {
    TLB_log_v("starting FOC!");
    simpleFOCstart(); // align encoder and start full FOC (not needed for open-loop)
  } else { TLB_log_v("skipping FOC init, we're running open-loop!"); }
  if(
  #if (ESC1_DEFINED) && defined(FOC_1_USE_HALL)
    (ESC1_motor.motor_status != FOCMotorStatus::motor_ready)
  #else
    0
  #endif
  #if (ESC2_DEFINED) && defined(FOC_2_USE_HALL)
    || (ESC1_motor.motor_status != FOCMotorStatus::motor_ready)
  #endif
  ) { // should be motor_ready, otherwise will be motor_calib_failed
    TLB_log_e("FOC init (calib) failed! %x",ESC1_motor.motor_status); neopixelWrite(RGB_BUILTIN, RGB_LED_ERROR);
    errorHaltHandler();
  }

  // //// DEBUG: move to relevant section (in TLB_ESC?)
  // #if (ESC1_DEFINED) && defined(FOC_1_USE_HALL)
  //   ESC1_motor.LPF_velocity.Tf = 0.05; // hall sensors have a low resolution, so the velocity-measurement Low-Pass filter should be adjusted accordingly
  //   // ESC1_motor.PID_velocity.P = 0.005; // just trying something
  //   // ESC1_motor.PID_velocity.I = 0.1; // just trying something
  // #endif
  // #if (ESC2_DEFINED) && defined(FOC_2_USE_HALL)
  //   ESC2_motor.LPF_velocity.Tf = 0.05; // hall sensors have a low resolution, so the velocity-measurement Low-Pass filter should be adjusted accordingly
  //   // ESC2_motor.PID_velocity.P = 0.005; // just trying something
  //   // ESC2_motor.PID_velocity.I = 0.1; // just trying something
  // #endif

  //// 'disabling' the motor seems to instruct the MOSFETs to connect all phases to GND, effectively creating resistive braking on the motor (generating a ton of heat)
  // ESC1_motor.freeWheel(); // freeWheel is a function i added, which does what i want 'disable' to do
  // ESC2_motor.freeWheel(); // freeWheel is a function i added, which does what i want 'disable' to do

  coreFOCsetup_flag = true; // inform other core

  while(1) { coreFOCloop(); } // finally, loop forever
}

TaskHandle_t core0task; // (global) task handler

void coreOtherLoop() {
  //// uint32_t one = ESP.getCycleCount(); // the current sensor LPF stuff below appears to take about ~330us, so that's not great
  // float cur_L_now = LPF_cur_L_debug(mes_Lcurrent());
  // float cur_M1_now = LPF_cur_M1_debug(mes_M1current());
  // float cur_M2_now = LPF_cur_M2_debug(mes_M2current());
  //// TODO: check for overcurrent? check_M_cur_bounds and check_M_cur_bounds_ext

  //// uint32_t two = ESP.getCycleCount();

  float VBAT_now = LPF_VBAT_debug(mes_VBAT());
  if((millis() - loopStartTime) > batteryCheckStartTime) {
    if((!batteryWarningDone) && ((VBAT_now < dynamic_VBAT_bounds[1]) || (VBAT_now > dynamic_VBAT_bounds[2]))) {
      batteryWarningDone = true; // avoid spam
      TLB_log_w("VBAT getting extreme: %.2f", VBAT_now);
      neopixelWrite(RGB_BUILTIN, RGB_LED_WARNING); // will remain in warning-mode untill something changes it
      //// TODO: limit max power?
    } else if((!batteryErrorDone) && ((VBAT_now < dynamic_VBAT_bounds[0]) || (VBAT_now > dynamic_VBAT_bounds[3]))) {
      batteryErrorDone = true; // avoid spam
      TLB_log_e("VBAT out of bounds!: %.2f", VBAT_now);
      neopixelWrite(RGB_BUILTIN, RGB_LED_ERROR); // 
      #ifdef DELAY_FREEWHEEL_UNTILL_SPEED_LOW
        delayedFreewheel=true;
        if(abs(newTargetUnscaledMultiCore) > 0.03) {
          float polarizedThrottle = (newTargetUnscaledMultiCore > 0.0) ? delayFreewheelThrotle : (-delayFreewheelThrotle);
          newTargetUnscaledMultiCore = polarizedThrottle; // multi-core communication
          newTargetUnscaledMultiCore_flag = true; // (minor optimization for the multi-core communication)
          #ifdef DELAY_FREEWHEEL_SMOOTHLY
            //// TODO: start timer?
          #endif
        }
      #else
        freewheelMultiCore = true;
      #endif
    }
  }

  //// uint32_t spd_now = LPF_speed_debug(two-one);

  temp_sensor_read_celsius(&CPU_temperature);
  if((CPU_temperature > CPU_temperature_limit) && CPU_temperature_good) { // if overheated
    CPU_temperature_good = false; // avoid spam
    TLB_log_w("CPU overtemp reached: %.2f", CPU_temperature);
    neopixelWrite(RGB_BUILTIN, RGB_LED_WARNING);
  } else if((!CPU_temperature_good) && (CPU_temperature < (CPU_temperature_limit-temperature_good_hyst))) { // once cooled down
    CPU_temperature_good = true;
    TLB_log_i("CPU overtemp restored");
    neopixelWrite(RGB_BUILTIN, RGB_LED_OK); // TODO: check other factors
  }

  static uint32_t lastTime = millis(); // note: static!
  if(TLB_rx.unpaired() || ((millis()-lastTime)>radioSilenceTimeout)) {
      if((!freewheelMultiCore)
        #ifdef DELAY_FREEWHEEL_UNTILL_SPEED_LOW // this code is not the MOST legible, but it does the job
          && (!delayedFreewheel)
        #endif
          ) { // only once
        #ifdef DELAY_FREEWHEEL_UNTILL_SPEED_LOW
          delayedFreewheel=true;
          if(abs(newTargetUnscaledMultiCore) > 0.03) {
            float polarizedThrottle = (newTargetUnscaledMultiCore > 0.0) ? delayFreewheelThrotle : (-delayFreewheelThrotle);
            newTargetUnscaledMultiCore = polarizedThrottle; // multi-core communication
            newTargetUnscaledMultiCore_flag = true; // (minor optimization for the multi-core communication)
            #ifdef DELAY_FREEWHEEL_SMOOTHLY
              //// TODO: start timer?
            #endif
          }
        #else
          freewheelMultiCore = true;
        #endif
        TLB_log_v("radio silence -> freewheeling"); neopixelWrite(RGB_BUILTIN, RGB_LED_INFO_2);
      }
      if(TLB_rx.update()) { lastTime = millis(); } // still need to run update function (to pair and such)
  } else {
    if(freewheelMultiCore && (!batteryErrorDone)) {
      #ifdef DELAY_FREEWHEEL_UNTILL_SPEED_LOW
        delayedFreewheel=false;
      #endif
      freewheelMultiCore=false;
      TLB_log_v("re-enabling");  neopixelWrite(RGB_BUILTIN, RGB_LED_OK);
    }
    if(TLB_rx.update()) {
      uint32_t thisTime = millis();
      int16_t newTargetRaw = TLB_rx.get(0);
      float newTargetConverted = 0.0;
      float currentSpeed = currentSpeedMultiCore; // copy volatile value
      #ifdef LEGACY_TRANSMITTER
        newTargetRaw -= 1000; // rtlopez/espnow-rclink library only deals in RC 880~2120 values
        lastTime = thisTime;
        if(newTargetRaw < 25) { // braking
          if(currentSpeed > 0.0f) {
            newTargetConverted = newTargetRaw; // copy int to float
            newTargetConverted -= 25.0f; // get negative number
            newTargetConverted *= (maxBrakingTorqueScalar / (25.0f)); // scale
            newTargetConverted *= min(1.0f, abs(currentSpeed) * _brakingDecreaseThreshInverted); // reduce braking below brakingDecreaseThresh
          }// else { newTargetConverted = 0.0;}
        } else if(newTargetRaw < 56) { // idling
          // if(freewheelMultiCore) { freewheelMultiCore = true }
          newTargetConverted = 0.0; // 0-torque is functional free-wheel
        } else if(CPU_temperature_good) { // positive throttle
          newTargetConverted = newTargetRaw - 55; // offset for zero-throttle
          newTargetConverted *= (maxForwardTorqueScalar / ((255.0f)-(55.0f))); // scale
        }// else { newTargetConverted = 0.0;}
      #else
        newTargetRaw -= 1500; // rtlopez/espnow-rclink library only deals in RC 880~2120 values
        if(newTargetRaw < 0) { // braking
          if(currentSpeed > 0.0f) {
            newTargetConverted = newTargetRaw; // copy int to float
            newTargetConverted *= (maxBrakingTorqueScalar / (128.0f)); // scale
            newTargetConverted *= min(1.0f, abs(currentSpeed) * _brakingDecreaseThreshInverted); // reduce braking below brakingDecreaseThresh
          }// else { newTargetConverted = 0.0;}
        } else if(newTargetRaw == 0) { // idling
          // if(freewheelMultiCore) { freewheelMultiCore = true }
          newTargetConverted = 0.0; // 0-torque is functional free-wheel
        } else if(CPU_temperature_good) { // positive throttle
          newTargetConverted = newTargetRaw; // copy int to float
          newTargetConverted *= (maxForwardTorqueScalar / (127.0f)); // scale
        }// else { newTargetConverted = 0.0;}
      #endif
      // TLB_log_v("received: %d->%.2f  %lu  %u", newTargetRaw, newTargetConverted, thisTime-lastTime, CPU_temperature_good);
      lastTime = thisTime;
      //if(coreFOCsetup_flag) // not needed
      newTargetUnscaledMultiCore = newTargetConverted; // multi-core communication
      newTargetUnscaledMultiCore_flag = true; // (minor optimization for the multi-core communication)
    }
  }

  #ifdef DELAY_FREEWHEEL_UNTILL_SPEED_LOW
    if(delayedFreewheel && (!freewheelMultiCore)) {
      float currentSpeed = currentSpeedMultiCore; // copy volatile value
      #ifdef DELAY_FREEWHEEL_SMOOTHLY
        #error("code is TODO!")
        //// TODO: do some math (using currentSpeed) to determine an appropriate throttle value (to slowly reach startFreewheelMaxSpeed)
      #endif
      if(abs(currentSpeed) < startFreewheelMaxSpeed) {
        freewheelMultiCore = true;
        newTargetUnscaledMultiCore = 0.0f; // multi-core communication
        newTargetUnscaledMultiCore_flag = true; // (minor optimization for the multi-core communication)
      }
    }
  #endif

  #if RELEASE_BUILD_CHECK
    if((millis()-debugPrintTimer)>=debugPrintInterval) {
      debugPrintTimer = millis();

      // ESC1_motor.monitor();
      // debugSerial.println(ESC1_sensor.getAngle());
      // debugSerial.println(ESC1_motor.shaft_velocity,6);
      // debugSerial.println(ESC1_motor.target);
      // debugSerial.printf("%.2f, %.2f\n", ESC1_motor.shaft_angle, ESC2_motor.shaft_angle);
      // debugSerial.printf("%.2f, %.2f\n", ESC1_motor.shaft_angle, ESC1_motor.shaft_velocity);
      // debugSerial.printf("%.2f, %.2f\n", ESC2_motor.shaft_angle, ESC2_motor.shaft_velocity);
      // debugSerial.printf("%.2f, %.2f\n", ESC1_motor.shaft_velocity * _RADPS_TO_KPH, ESC2_motor.shaft_velocity * _RADPS_TO_KPH);
      // debugSerial.printf("cur %.2f,  %.2f, %.2f \t VBAT: %.2f\n", cur_L_now, cur_M1_now, cur_M2_now, VBAT_now);
      // debugSerial.printf("spd: %lu\n", spd_now);
      // debugSerial.printf("CPU temp: %.2f\n",CPU_temperature);
      // debugSerial.printf("VBAT_now: %.3f\n",VBAT_now);
    }
  #endif
}

void coreOtherSetup(void* arg) { // all non-FOC related stuff
  while(!coreFOCsetup_flag) { delay(1); } // wait for FOC core to finish setup (not strictly needed, but i like it)

  //// receiver stuff (move to better location?)
  /*bool initSuccess = */
  TLB_rx.begin(true); // init ESP-NOW receiver (incl. softAP)
  TLB_rx.setSensor(0, VBAT_used_for_FOC*100);
  //delay(100); // this delay could help prevent debug message prints colliding (between cores and ISRs)
  
  //// if it made it here, all is OK, let's fucking go
  // TLB_log_v("let's fucking go"); // this message collides with debug prints from an ISR (from WiFiGeneric)
  neopixelWrite(RGB_BUILTIN, RGB_LED_OK);

  loopStartTime = millis(); // make simple sinusoid input start at 0, instead of starting at high speed

  while(1) { coreOtherLoop(); } // finally, loop forever
}

/////////////////////////////////////////// main setup //////////////////////////////////////////

void setup() {
  initRGB_LED(RGB_LED_INFO_3); // setup RGB LED (for debug) (note: LED init is done early, for easier debug)
  #if(RELEASE_BUILD_CHECK) // if this is NOT a release build
    delay(250); // patch, because USBCDC can't be bothered to wait
    debugSerial.begin(115200);
    debugSerial.setDebugOutput(true); // posts ESP (RTOS) debug here as well?
    // while(!debugSerial) { /*wait*/ } // doesn't wait for serial port to be OPENEND, BUT i believe it enabled re-uploading?!? (not sure why, but uploading can fail without this check)
  #else
    delay(25); // to be improved, but it seems prudent to give the seperate systems a little time to boot
  #endif
  TLB_log_d("boot %s %s", __DATE__, __TIME__); // even in release build, print something to me know the ESP is alive (and which code it's running)

  initEXT_PERIPHpins();
  TLB_log_v("EXT_PERIPH init done");

  initPSUs(); // setup step-down converter pins
  TLB_log_v("PSU init done");
  delay(10); // idk, why not
  initADCpins(); // setup ADC pins
  TLB_log_v("ADC init done");

  initTempSensor();  temp_sensor_read_celsius(&CPU_temperature);
  // TLB_log_v("temp sensor init done");
  
  VBAT_used_for_FOC = mes_VBAT();
  TLB_log_i("VBAT used for FOC: %.2f",VBAT_used_for_FOC);
  cellCount = lithiumCellCalc(VBAT_used_for_FOC);
  TLB_log_i("cell count: %d",cellCount);
  if(!setDynamicVBATbounds(dynamic_VBAT_bounds, cellCount)) { // usually succeeds, but may fail during power-supply debugging
    dynamic_VBAT_bounds[0]=check_VBAT_bounds_ext[0];  dynamic_VBAT_bounds[1]=check_VBAT_bounds[0];
    dynamic_VBAT_bounds[2]=check_VBAT_bounds[1];  dynamic_VBAT_bounds[3]=check_VBAT_bounds_ext[1];
  }
  TLB_log_i("dynamic VBAT bounds: %.2f~%.2f <-> %.2f~%.2f",dynamic_VBAT_bounds[0],dynamic_VBAT_bounds[1],dynamic_VBAT_bounds[2],dynamic_VBAT_bounds[3]);
  // if(cellCount >= minimumCellCount) { VBAT_used_for_FOC = cellCount * _lithiumCellThresholds[2]; } // set limits to typical fully charged cell voltage

  delay(10); // idk, why not
  if(FOC_core) {
    xTaskCreatePinnedToCore(
        coreOtherSetup, /* Function to implement the task */
        "otherTask", /* Name of the task */
        10000,  /* Stack size in words */
        NULL,  /* Task input parameter */
        0,  /* Priority of the task */
        &core0task,  /* Task handle. */
        0); /* Core where the task should run */
    coreFOCsetup(NULL); // run FOC code on core 1 (loops forever)
  } else {
    xTaskCreatePinnedToCore(
      coreFOCsetup, /* Function to implement the task */
      "FOCtask", /* Name of the task */
      10000,  /* Stack size in words */
      NULL,  /* Task input parameter */
      0,  /* Priority of the task */
      &core0task,  /* Task handle. */
      FOC_core); /* Core where the task should run */
    coreOtherSetup(NULL); // run other code on core 1 (loops forever)
  }
}


/////////////////////////////////////////// main loop ///////////////////////////////////////////

void loop() {} // never reached (see coreOtherLoop() and coreFOCloop())
