thijses/longboard_2024/boards/variants/TLB_variant/pins_arduino.h

#ifndef Pins_Arduino_h
#define Pins_Arduino_h

#include <stdint.h>
#include "soc/soc_caps.h"

#define USB_VID 0x303a
#define USB_PID 0x1001

//// this file was slightly modified (as intended)
#if defined(TLB_PCB_R01) || (TLB_PCB_R02)
  static const uint8_t LED_BUILTIN = SOC_GPIO_PIN_COUNT + 41; // PCB R01 has a neopixel (SK6812D-EC3210R) LED on pin 41
#else
  #error("no PCB revision defined, what pin has the LED?")
#endif
#define BUILTIN_LED  LED_BUILTIN // backward compatibility
#define LED_BUILTIN LED_BUILTIN  // allow testing #ifdef LED_BUILTIN
// RGB_BUILTIN and RGB_BRIGHTNESS can be used in new Arduino API neopixelWrite()
#define RGB_BUILTIN LED_BUILTIN
#define RGB_BRIGHTNESS 64


static const uint8_t TX = 43;
static const uint8_t RX = 44;

static const uint8_t SDA = 8;
static const uint8_t SCL = 9;

static const uint8_t SS    = 10;
static const uint8_t MOSI  = 11;
static const uint8_t MISO  = 13;
static const uint8_t SCK   = 12;

static const uint8_t A0 = 1;
static const uint8_t A1 = 2;
static const uint8_t A2 = 3;
static const uint8_t A3 = 4;
static const uint8_t A4 = 5;
static const uint8_t A5 = 6;
static const uint8_t A6 = 7;
static const uint8_t A7 = 8;
static const uint8_t A8 = 9;
static const uint8_t A9 = 10;
static const uint8_t A10 = 11;
static const uint8_t A11 = 12;
static const uint8_t A12 = 13;
static const uint8_t A13 = 14;
static const uint8_t A14 = 15;
static const uint8_t A15 = 16;
static const uint8_t A16 = 17;
static const uint8_t A17 = 18;
static const uint8_t A18 = 19;
static const uint8_t A19 = 20;

static const uint8_t T1 = 1;
static const uint8_t T2 = 2;
static const uint8_t T3 = 3;
static const uint8_t T4 = 4;
static const uint8_t T5 = 5;
static const uint8_t T6 = 6;
static const uint8_t T7 = 7;
static const uint8_t T8 = 8;
static const uint8_t T9 = 9;
static const uint8_t T10 = 10;
static const uint8_t T11 = 11;
static const uint8_t T12 = 12;
static const uint8_t T13 = 13;
static const uint8_t T14 = 14;

#endif /* Pins_Arduino_h */
