thijses/longboard_2024/(commit log)

2024-05-22 post-testing i drove a few kilometers, and made some changes as a result: - switched to using the spaceVectorPWM algorithm (instead of trapezoid120), because this is faster/better and my hall sensors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
    [TLB_ESCs.h, TLB_analog.h, main.cpp]
2024-05-23 real update added multi-core usage (because FOC was getting bad performance due to safety additions to the loop()) updated board config (including fixing JTAG, finally) (NOTE: PCB R01 SN 2 has some u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
    [TLB_analog.h, TLB_pinouts.h, main.cpp, pins_arduino.h]
2024-08-30 testing high speed i've turned off all the limits, so i can get that all-important 35KPH goal. I've also implemented a new little safety feature: when something goes wrong (like radio silence, batter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
    [TLB_ESCs.h, main.cpp, pins_arduino.h]
2026-06-09 untested phase current sense I added some code to try testing the phase current sensing i added to R02 This code is UNTESTED, but i believe i followed the wiki (https://docs.simplefoc.com/low_side_cu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
    [TLB_ESCs.h, TLB_pinouts.h, main.cpp, pins_arduino.h]
